sam-winchy/Bluetooth-Temperature-Sensor-Network/README.md

# Bluetooth-Temperature-Sensor-Network
My University Dissertation. A project for creating a master module which can take readings from multiple sensor modules. The repository contains everything you'll neeed to get this project up and running.If you have any question please feel free to ask.

Please Read Instructions file for directions
